xiaoxiaokade/IMU/IMU_base_V7.2/IMU_base_V7.2.kicad_pcb

## KiCad design IMU_base_V7.2/IMU_base_V7.2.kicad_pcb (2023-04-14)

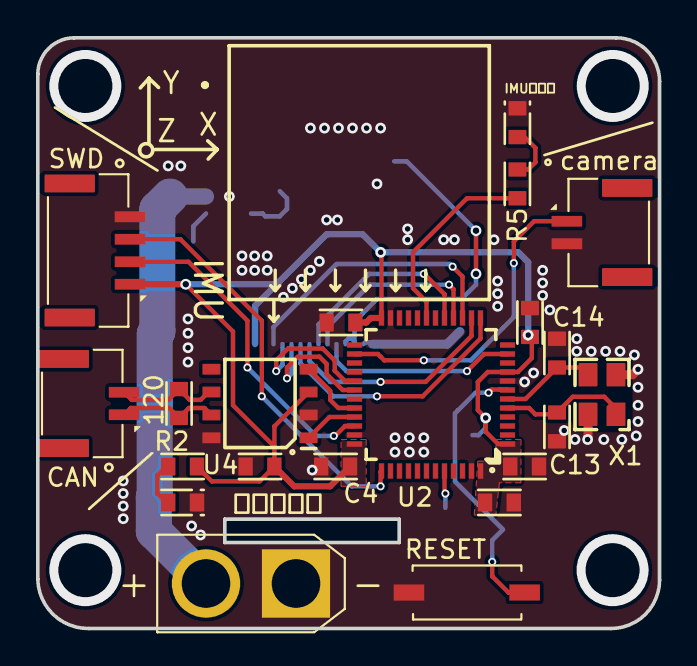
[picture p1: board IMU_base_V7.2.kicad_pcb from above]

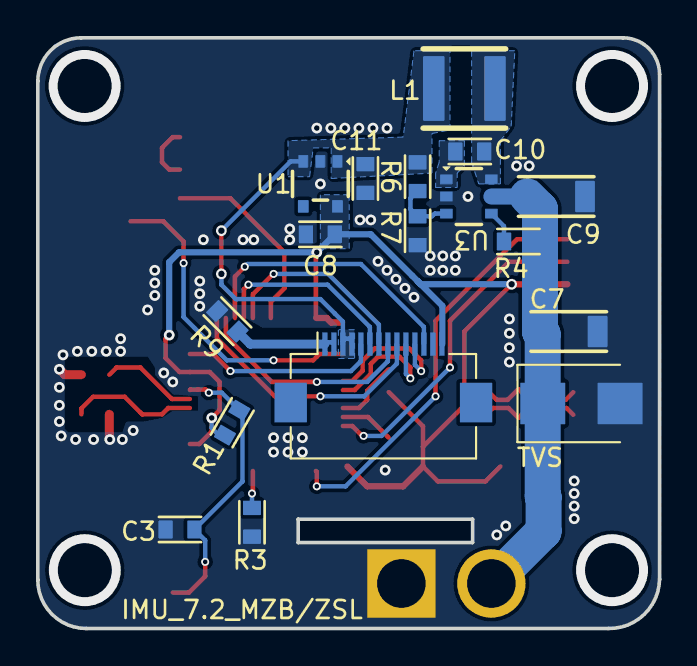
[picture p2: board IMU_base_V7.2.kicad_pcb from below]

Board: 2 copper layers, 34.5 x 32.8 mm, 38 parts (17 on the bottom side), 31 nets.

Parts:
120: 120R; R0603(1608M)
C1, C2, C3, C4, C5, C6: 104; C0603(1608M)
C7: 22uF/1206/35V; C1206(3216M)
C8, C11: 10uF; C0603(1608M)
C9: 22uF/35V/1206; C1206(3216M)
C10: 100nF; C0603(1608M)
C12: 10nF; C0603(1608M)
C13, C14: 18pF; C0603(1608M)
CAN: Conn_01x02; GH1.25_V_2
IMU指示灯: 蓝灯; LED0603(1608M)
J2: Conn_01x02; AMASS_XT30U-M_1x02_P5.0mm_Vertical
J4: Conn_01x14; Hirose_FH12-14S-0.5SH_1x14-1MP_P0.50mm_Horizontal
L1: 22uH; L_SWPA4030S
R1, R2, R3, R5: 1K; R0603(1608M)
R4: 100K; C0603(1608M)
R6: 43K; C0603(1608M)
R7: 8.2K; C0603(1608M)
R9: 0R; R0603(1608M)
RESET: SW_DIP_x01; Swith_3_6_2.5MM
SWD: Conn_01x04; GH1.25_V_4
TVS: Diode_TVS_Bi; D_SMB
U1: HX9193-33GB; SOT-23-5
U2: STM32F103C8Tx; QFP-7070_48
U3: TD1469; SOT-23-6
U4: VP230; SOP-3949_8
X1: Xtal-4; SMD-3225_4
camera: Conn_01x02; GH1.25_V_2
电源指示灯: 红灯; LED0603(1608M)

Connections:
+3V3: C1.1, C2.1, C4.1, C5.1, C6.1, C8.2, C12.2, J4.14, R1.1, R2.2, SWD.1, U1.5 (VOUT), U2.1 (Vbat), U2.9 (Vin_A), U2.24 (Vin), U2.36 (Vin), U2.48 (Vin), U4.3 (Vin)
+5V: C11.1, J4.3, J4.4, L1.2, R6.1, U1.1 (VIN), U1.3 (EN)
+24V: C7.1, C9.1, J2.2, R4.1, TVS.1 (Cathode), U3.5 (VIN)
/BOOT0: R3.1, U2.44 (BOOT0)
/CAN0_RX: U2.32 (PA11), U4.4 (Rx_D)
/CAN0_TX: U2.33 (PA12), U4.1 (Tx_D)
/CAN_H: 120.2, CAN.1, U4.7 (CAN_H)
/CAN_L: 120.1, CAN.2, U4.6 (CAN_L)
/CS1_Acce1: J4.11, U2.29 (PA8)
/CS1_Gyro: J4.10, U2.30 (PA9)
/INT1_Acce1: J4.9, U2.13 (PA3)
/INT1_Gyro: J4.8, U2.14 (PA4)
/LED: R5.2, U2.19 (PB1)
/RESET: C3.1, R1.2, RESET.1, U2.7 (nRST)
/SPI1_CLK: J4.12, U2.15 (PA5)
/SPI1_MISO: J4.6, U2.16 (PA6)
/SPI1_MOSI: J4.7, U2.17 (PA7)
/SWCLK: SWD.3, U2.37 (PA14)
/SWDIO: SWD.2, U2.34 (PA13)
/TIM10_CH1: J4.5, U2.11 (PA1)
/XTAL0: C13.2, U2.5 (PD0), X1.1
/XTAL1: C14.2, U2.6 (PD1), X1.3
GND: C1.2, C2.2, C3.2, C4.2, C5.2, C6.2, C7.2, C8.1, C9.2, C11.2, C12.1, C13.1, C14.1, IMU指示灯.1 (Cathode), J2.1, J4.13, R3.2, R7.1, R9.1, RESET.2, SWD.4, TVS.2 (Anode), U1.2 (GND), U2.8 (GND_A), U2.23 (GND), U2.35 (GND), U2.47 (GND), U3.2 (GND), U4.2 (GND), U4.8 (STB), X1.2, X1.4, camera.2, 电源指示灯.1 (Cathode)
GNDPWR: J4.1, J4.2, R9.2
unnamed: C10.1, U3.1 (BST)
unnamed: C10.2, L1.1, U3.6 (SW)
unnamed: R2.1, 电源指示灯.2 (Anode)
unnamed: IMU指示灯.2 (Anode), R5.1
unnamed: U2.26 (PB13), camera.1
unnamed: R4.2, U3.4 (EN)
unnamed: R6.2, R7.2, U3.3 (FB)
