xiaoxiaokade/IMU/IMU_base_V7.1/IMU_base_V7.1/IMU_base_V7.1.kicad_pcb

## KiCad design IMU_base_V7.1/IMU_base_V7.1/IMU_base_V7.1.kicad_pcb (2022-12-05, an earlier design)

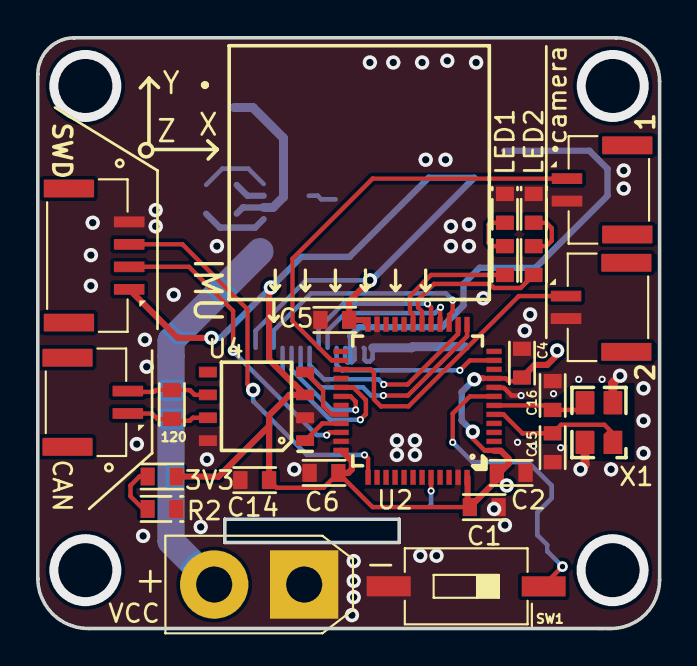
[picture p3: board IMU_base_V7.1.kicad_pcb from above]

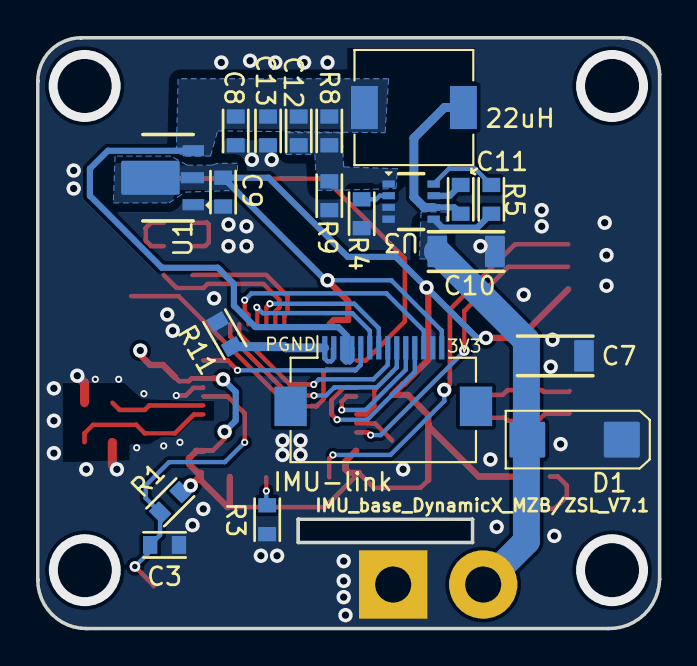
[picture p4: board IMU_base_V7.1.kicad_pcb from below]

Board: 2 copper layers, 34.5 x 32.8 mm, 44 parts (20 on the bottom side), 34 nets.

Parts:
3V3: 红灯; LED0603(1608M)
22uH: 22uH; L_6.3x6.3_H3
120: 120R; R0603(1608M)
C1, C2, C3, C4, C5, C6: 104; C0603(1608M)
C7: 22uF/1206/35V; C1206(3216M)
C8, C9: 10uF; C0603(1608M)
C10: 4.7uF/1206/35V; C1206(3216M)
C11, C12, C14: 10nF; C0603(1608M)
C13: 22uF; C0603(1608M)
C15, C16: 18pF; C0603(1608M)
D1: Diode_TVS_Bi; Suppresses_transient_diodes_IMU
J1: Conn_01x04; GH1.25_V_4
J3, J4, J6: Conn_01x02; GH1.25_V_2
J5: Conn_01x14; Hirose_FH12-14S-0.5SH_1x14-1MP_P0.50mm_Horizontal
LED1: 绿灯; LED0603(1608M)
LED2: 蓝灯; LED0603(1608M)
R1, R2, R3, R6, R7: 1K; R0603(1608M)
R4, R5: 100k; R0603(1608M)
R8: 150k; R0603(1608M)
R9: 20.5k; R0603(1608M)
R11: 0R; R0603(1608M)
SW1: SW_DIP_x01; SW_DIP_SPSTx01_Slide_6.7x4.1mm_W8.61mm_P2.54mm_LowProfile
U1: AMS1117; SOT-89
U2: STM32F103C8Tx; QFP-7070_48
U3: SY8303; SOT-23-8
U4: VP230; SOP-3949_8
VCC: Conn_01x02; AMASS_XT30U-M_1x02_P5.0mm_Vertical
X1: Xtal-4; SMD-3225_4

Connections:
+3V3: C1.1, C2.1, C4.1, C5.1, C6.1, C9.2, C14.2, J1.1, J5.14, R1.1, R2.2, U1.2 (VOUT), U2.1 (Vbat), U2.9 (Vin_A), U2.24 (Vin), U2.36 (Vin), U2.48 (Vin), U4.3 (Vin)
+5V: 22uH.2, C8.2, C12.2, C13.2, J5.3, J5.4, R8.1, U1.3 (VIN)
+24V: C7.1, C10.2, D1.1 (Cathode), R5.1, U3.5 (VIN), VCC.2
/BOOT0: R3.1, U2.44 (BOOT0)
/CAN0_RX: U2.32 (PA11), U4.4 (Rx_D)
/CAN0_TX: U2.33 (PA12), U4.1 (Tx_D)
/CAN_H: 120.2, J6.1, U4.7 (CAN_H)
/CAN_L: 120.1, J6.2, U4.6 (CAN_L)
/CS1_Acce1: J5.11, U2.29 (PA8)
/CS1_Gyro: J5.10, U2.30 (PA9)
/INT1_Acce1: J5.9, U2.13 (PA3)
/INT1_Gyro: J5.8, U2.14 (PA4)
/LED1: R7.2, U2.19 (PB1)
/RESET: C3.1, R1.2, SW1.1, U2.7 (nRST)
/SPI1_CLK: J5.12, U2.15 (PA5)
/SPI1_MISO: J5.6, U2.16 (PA6)
/SPI1_MOSI: J5.7, U2.17 (PA7)
/SWCLK: J1.3, U2.37 (PA14)
/SWDIO: J1.2, U2.34 (PA13)
/TIM10_CH1: J5.5, U2.11 (PA1)
/XTAL0: C15.2, U2.5 (PD0), X1.1
/XTAL1: C16.2, U2.6 (PD1), X1.3
GND: 3V3.1 (Cathode), C1.2, C2.2, C3.2, C4.2, C5.2, C6.2, C7.2, C8.1, C9.1, C10.1, C13.1, C14.1, C15.1, C16.1, D1.2 (Anode), J1.4, J3.2, J4.2, J5.13, LED1.1 (Cathode), LED2.1 (Cathode), R3.2, R4.1, R9.1, R11.1, SW1.2, U1.1 (GND), U2.8 (GND_A), U2.23 (GND), U2.35 (GND), U2.47 (GND), U3.3 (GND), U3.4 (GND), U4.2 (GND), U4.8 (STB), VCC.1, X1.2, X1.4
GNDPWR: J5.1, J5.2, R11.2
unnamed: C11.1, U3.7 (BST)
unnamed: 22uH.1, C11.2, U3.6 (SW)
unnamed: C12.1, R8.2, R9.2, U3.1 (FB)
unnamed: 3V3.2 (Anode), R2.1
unnamed: LED1.2 (Anode), R6.1
unnamed: LED2.2 (Anode), R7.1
unnamed: J3.1, U2.26 (PB13)
unnamed: J4.1, U2.27 (PB14)
unnamed: R4.2, U3.2 (FS)
unnamed: R5.2, U3.8 (EN)
