xiaoxiaokade/IMU/(commit log)

2022-12-05 ADD IMU_base_V7 and V7.1
    [IMU_base_V7-B_Cu.gbr, IMU_base_V7-B_Mask.gbr, IMU_base_V7-B_Paste.gbr, IMU_base_V7-B_Silkscreen.gbr, IMU_base_V7-Edge_Cuts.gbr, IMU_base_V7-F_Cu.gbr, IMU_base_V7-F_Mask.gbr, IMU_base_V7-F_Paste.gbr]
2022-12-05 README
    IMU_base_V7是IMU底板的第七版，更换了DCDC芯片，换成SY8303，电源已稳定，但电感选型有误，其饱和电流太小。
    IMU_base_V7.1在IMU_base_V7的基础上，换了饱和电流更大的功率电感，并且改正了一些如丝印错误、元件位置放置不佳等小问题。
    IMU_BMI088是FPC软板。由于BMI088的工作温度在60°左右，故需将其与底板隔开。
2023-04-14 ADD IMU_BaseV7.2
    [IMU_base_V7.2.kicad_pcb, IMU_base_V7.2.kicad_sch]
2023-04-14 ADD IMU_base_V7.2
    [IMU_base_V7.2.kicad_pcb, IMU_base_V7.2.kicad_sch]
